SadeepaPerera/Voice-Controllable-Smart-Emergency-Bulb/README.md

# Voice-Controllable-Smart-Emergency-Bulb

Introducing The Voice Controllable Smart Emergency Bulb – the pinnacle of lighting innovation. Seamlessly integrated with Amazon Alexa, it responds effortlessly to your voice commands. Control is at your fingertips with easy mobile phone operation. Choose from an extensive palette of colors, setting the perfect mood for any occasion. Fine-tune brightness levels to your preference. Enjoy the convenience of remote on/off functionality, all while requiring only a WiFi connection. This versatile bulb features rechargeable batteries, ensuring uninterrupted illumination, even during power outages. Experience a new era in lighting technology, providing both style and functionality. Illuminate your space with unparalleled ease and reliability. Your intelligent lighting solution awaits!
