SadeepaPerera/Voice-Controllable-Smart-Emergency-Bulb/Schematic diagram.pdf

## Power Supply

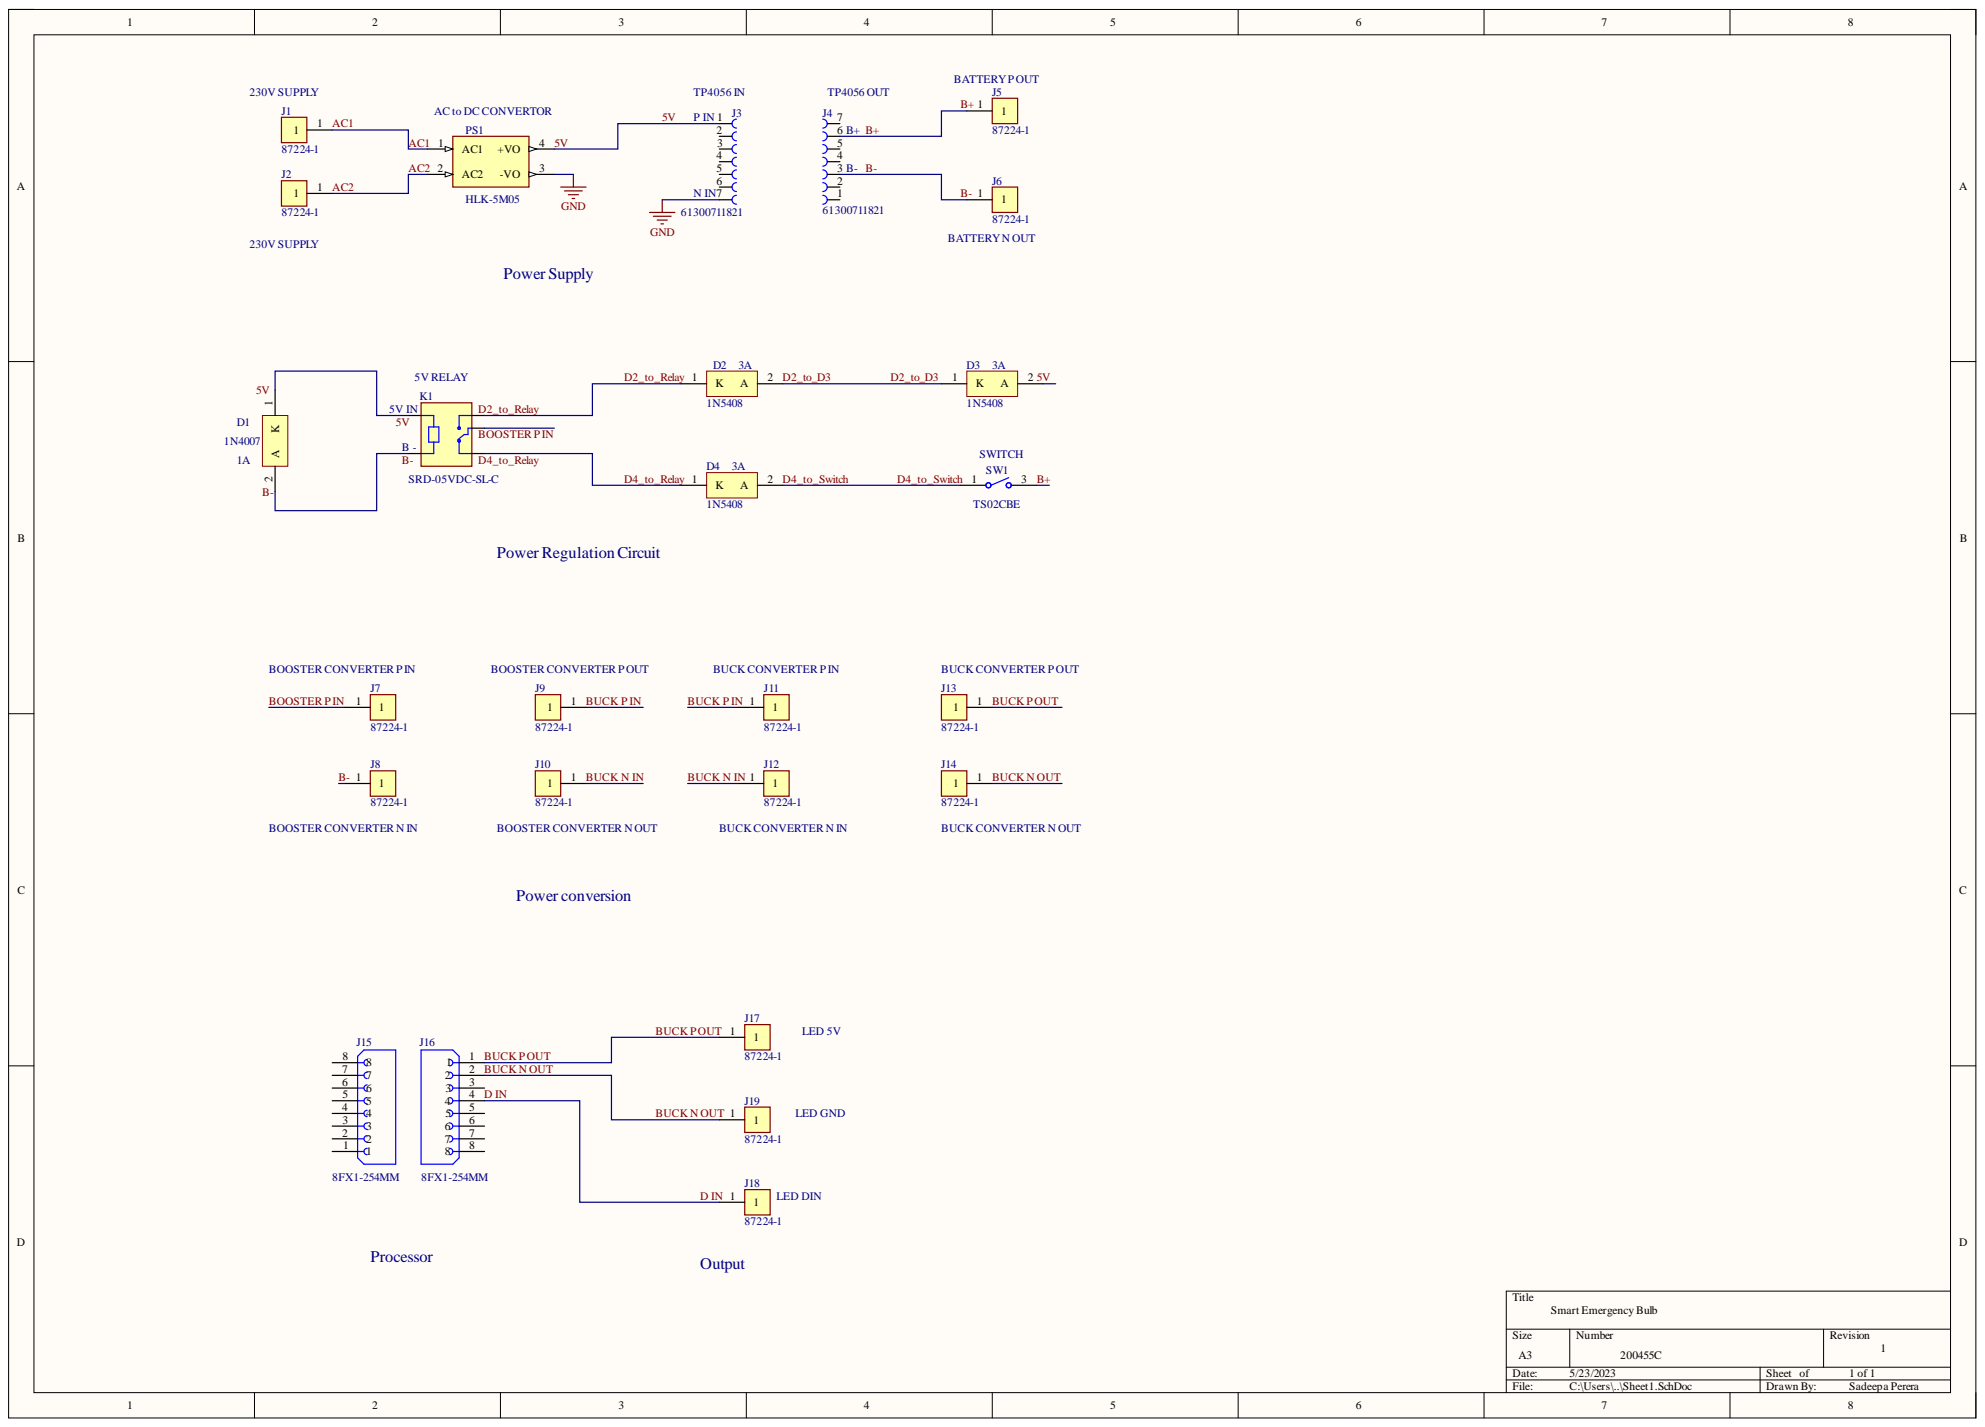
[picture p30: page 1]

AC to DC CONVERTOR
